zevaryx/ender-5-mint-edition/docs/index.md

---
icon: lucide/rocket
---

# Getting started

## About this project

This project is a way to maximize the capabilities of the Ender 5 Max. Creality leaves a lot of performance on the table, as well as made questionable decisions with the electronics.

!!! danger "Advanced Project"

    This project is not for the faint of heart. You will be replacing all of the core electronics and the toolhead with custom parts. This projects comes with no warranty, and I do not claim any responsibility for damage to the printer, you, or to your housing. Fires are a serious risk when doing this project, and the danger of electrocution is present when dealing with mains voltage.

    **You have been warned**

## Results

<video width="1080" height="1920" controls>
  <source src="media/videos/0-benchy-smaller.mp4" type="video/mp4">
</video>

<video width="1080" height="1920" controls>
  <source src="media/videos/1-benchy-smaller.mp4" type="video/mp4">
</video>

## CAD Files

### Enclosure

<iframe src="https://unco1.autodesk360.com/shares/public/SH28cd1QT2badd0ea72b91c8bcb635015e0a?mode=embed" width="800" height="600" allowfullscreen="true" webkitallowfullscreen="true" mozallowfullscreen="true"  frameborder="0"></iframe>

### EVA3 UHF Duct for Cartographer V4

Uses a Rapido 2 UHF hotend as the example

<iframe src="https://unco1.autodesk360.com/shares/public/SH28cd1QT2badd0ea72b017430b5294d3c46?mode=embed" width="800" height="600" allowfullscreen="true" webkitallowfullscreen="true" mozallowfullscreen="true"  frameborder="0"></iframe>

| Part | Fusion | STEP |
| --- | --- | --- |
| Enclosure | [.f3z](cad/enclosure/Ender%205%20Max%20Manta%20M8P%2048V%20Enclosure.f3z) | [.step](cad/enclosure/Ender%205%20Max%20Manta%20M8P%2048V%20Enclosure.step) |
| EVA3 UHF Duct | [.f3z](cad/eva3/EVA3%20UHF%20Duct%20Cartographer%20V4.f3d) | [.step](cad/eva3/EVA3%20UHF%20Duct%20Cartographer%20V4.step) |

## Recommended tools

!!! info

    This list is not exhaustive, and just what I could come up with off the top of my head

- A good soldering iron (Pinecil V2, TS100/101, FNISRI HS-02A/B, anything Weller/Hakko, etc)
- CNCKitchen heat-set insert tool for your soldering iron
- A good set of allen wrenches
- A good pair of wire strippers
- Ferrule crimps and a crimper for them
- Fork crimps and a crimper for them
- A good JST crimper and various sizes of JST plugs and crimps
- High-quality wire of various gauges, including large gauge for mains voltage (I used trailer wiring from Home Depot)
- Zip ties. Lots and lots of zip ties
- Flush cutters
