zevaryx/ender-5-mint-edition/docs/stl/enclosure/LRS-350-24.stl

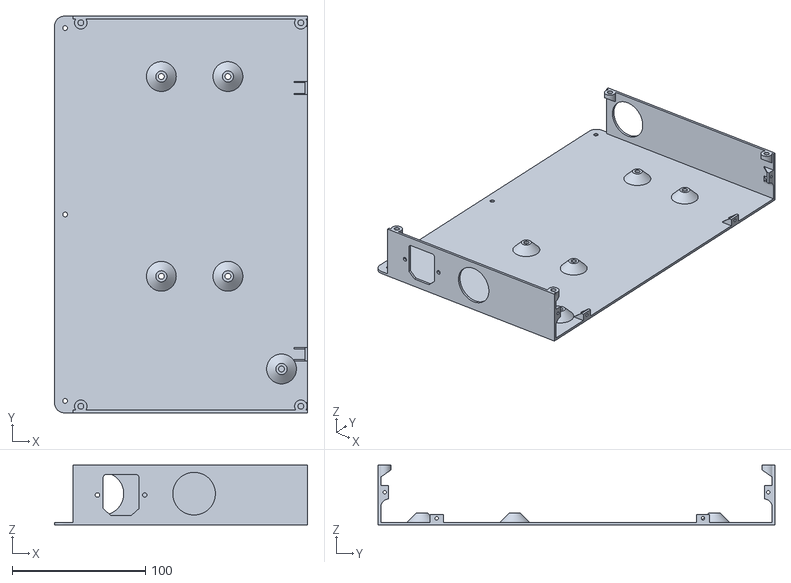
[picture p4: CAD file, 2025-12-09]
docs/stl/enclosure/LRS-350-24.stl
190.0 x 298.0 x 45.0
