zevaryx/ender-5-mint-edition/docs/stl/eva3/EVA3 UHF Duct Cartographer V4.3mf

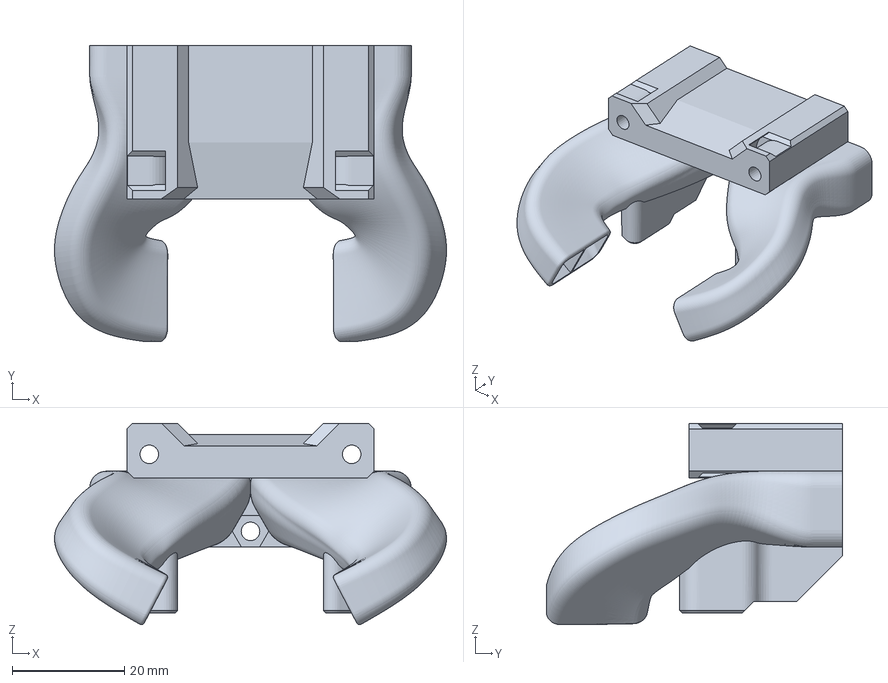
[picture p5: CAD file, 2025-12-19]
docs/stl/eva3/EVA3 UHF Duct Cartographer V4.3mf
69.7 x 52.7 x 35.8 mm
