zevaryx/ender-5-mint-edition/docs/stl/enclosure/Foot Extension x4.stl

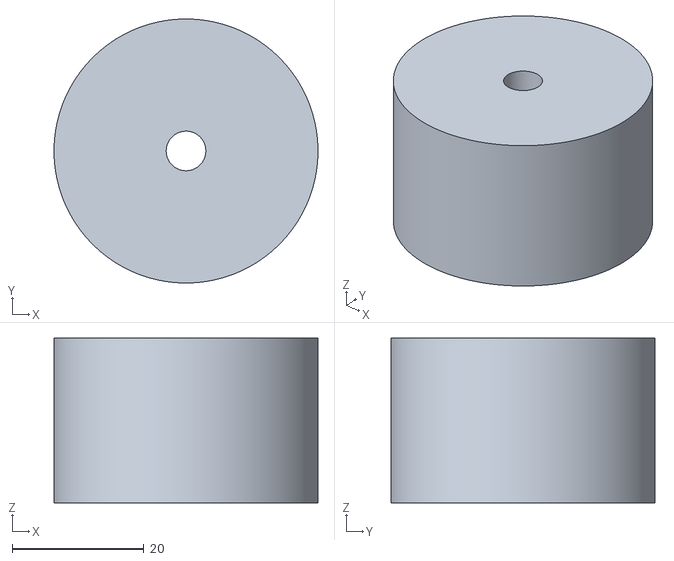
[picture p6: CAD file, 2025-12-09]
docs/stl/enclosure/Foot Extension x4.stl
40.0 x 40.0 x 25.0
