zevaryx/ender-5-mint-edition/docs/stl/eva3/E5M EVA Back Insert.stl

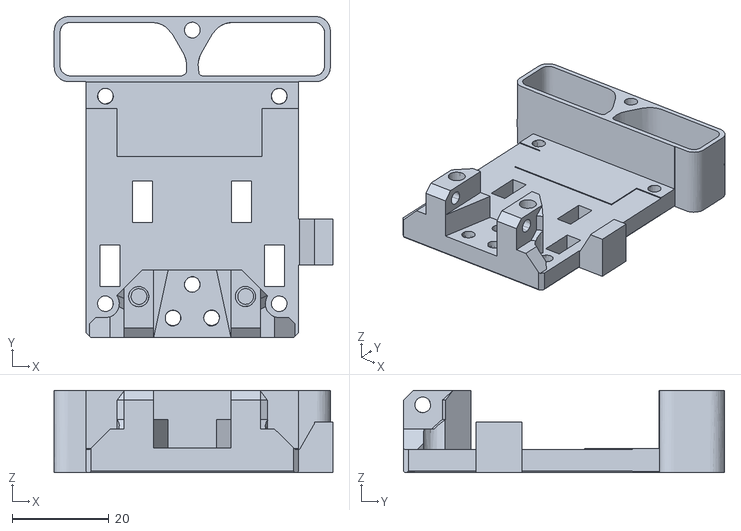
[picture p7: CAD file, 2025-12-09]
docs/stl/eva3/E5M EVA Back Insert.stl
57.7 x 66.5 x 17.0
