zevaryx/ender-5-mint-edition/docs/stl/enclosure/Manta M8P.stl

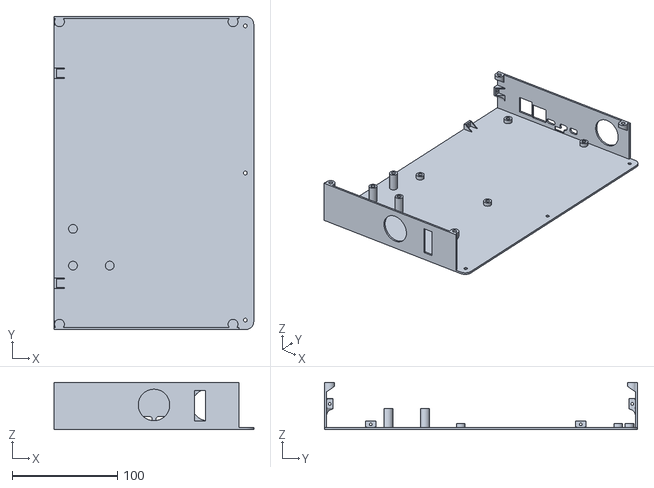
[picture p8: CAD file, 2025-12-09]
docs/stl/enclosure/Manta M8P.stl
190.0 x 298.0 x 45.0
