zevaryx/ender-5-mint-edition/docs/stl/eva3/E5M EVA Top Insert.stl

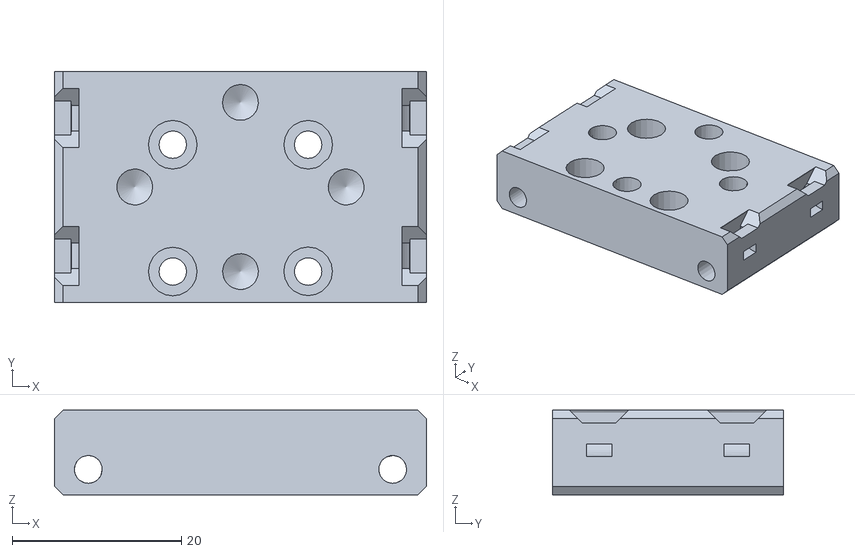
[picture p9: CAD file, 2025-12-09]
docs/stl/eva3/E5M EVA Top Insert.stl
44.0 x 27.3 x 10.0
