zevaryx/ender-5-mint-edition/docs/stl/enclosure/Bottom Mesh - LRS-200-48.stl

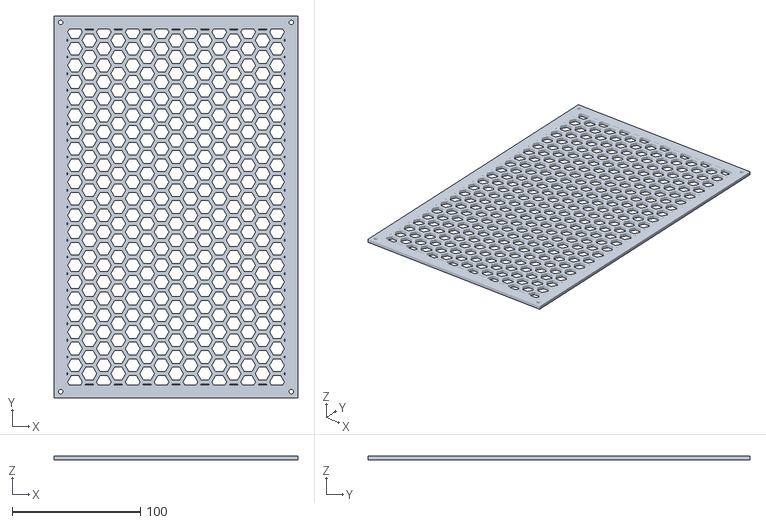
[picture p10: CAD file, 2025-12-09]
docs/stl/enclosure/Bottom Mesh - LRS-200-48.stl
190.0 x 298.0 x 3.00
