zevaryx/ender-5-mint-edition/docs/stl/eva3/E5M EBB36 Orbiter Mount.stl

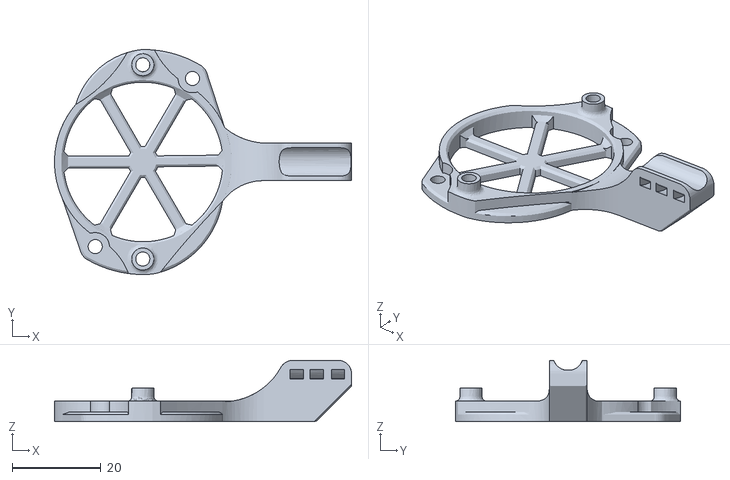
[picture p11: CAD file, 2025-12-09]
docs/stl/eva3/E5M EBB36 Orbiter Mount.stl
67.0 x 50.8 x 13.9
