zevaryx/ender-5-mint-edition/docs/stl/enclosure/Bottom Mesh - Manta M8P.stl

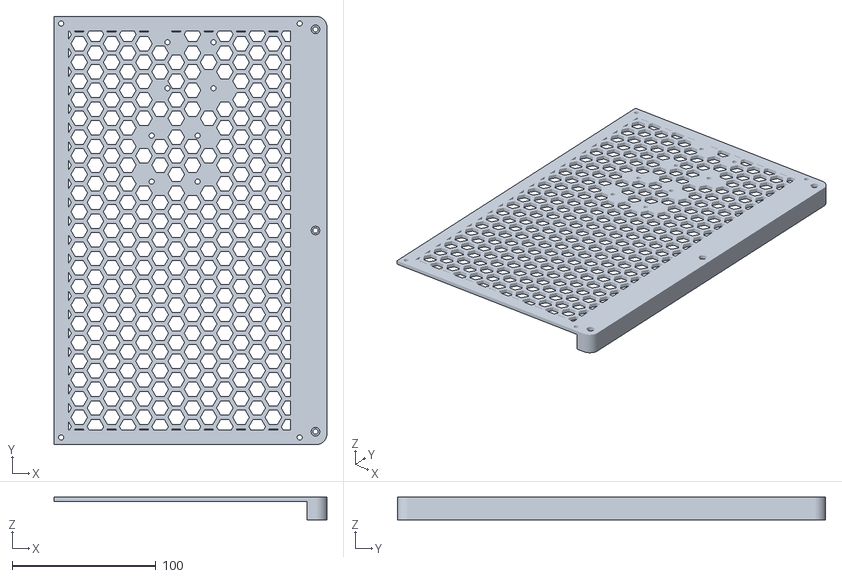
[picture p12: CAD file, 2025-12-09]
docs/stl/enclosure/Bottom Mesh - Manta M8P.stl
190.0 x 298.0 x 16.0
