zevaryx/ender-5-mint-edition/docs/stl/eva3/E5M SFS Mount.stl

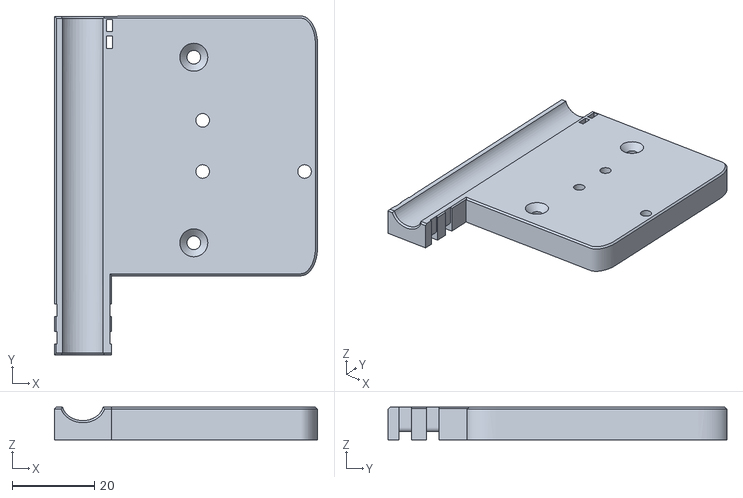
[picture p13: CAD file, 2025-12-09]
docs/stl/eva3/E5M SFS Mount.stl
63.8 x 82.2 x 7.99
