zevaryx/ender-5-mint-edition/docs/stl/eva3/E5M EVA Front Insert.stl

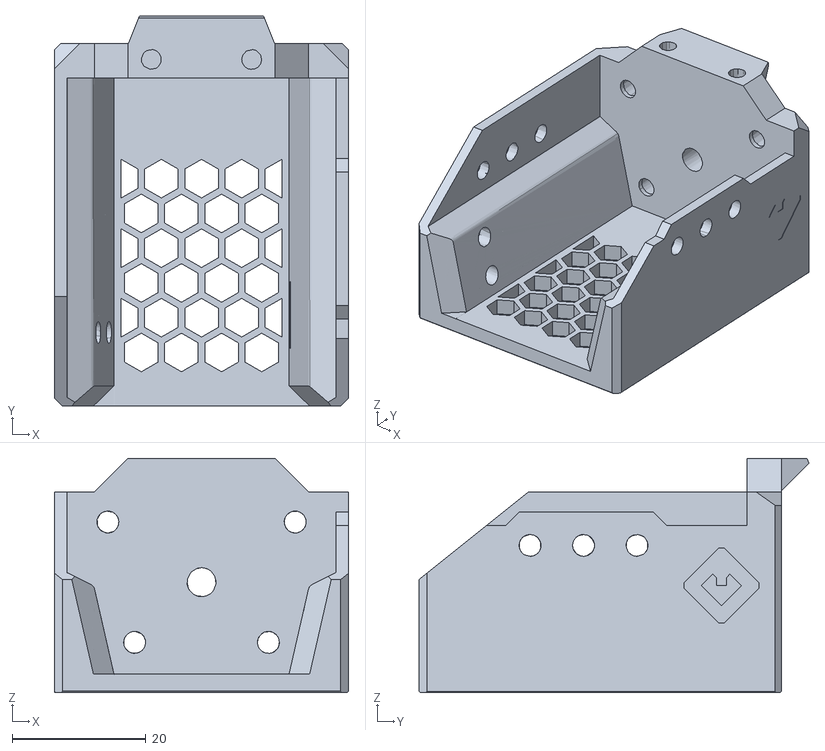
[picture p14: CAD file, 2025-12-09]
docs/stl/eva3/E5M EVA Front Insert.stl
44.0 x 58.3 x 35.0
