zevaryx/ender-5-mint-edition/(list of files, cad)

Other CAD files:
docs/stl/enclosure/LRS-200-48.stl
docs/stl/enclosure/Bottom Mesh - LRS-350-24.stl
docs/cad/eva3/EVA3 UHF Duct Cartographer V4.f3d
