zevaryx/ender-5-mint-edition/(commit log)

2025-12-09 Starts of the BOM
2025-12-09 Add mostly finished BOM, Getting Started
    [Bottom Mesh - LRS-200-48.stl, Bottom Mesh - LRS-350-24.stl, Bottom Mesh - Manta M8P.stl, E5M EBB36 Orbiter Mount.stl, E5M EVA Back Insert.stl, E5M EVA Front Insert.stl, E5M EVA Top Insert.stl, E5M SFS Mount.stl]
2025-12-09 Add CAD files and embedded Fusion viewer
2025-12-10 Add basics of assembly guide
2025-12-10 Add more to assembly guide
2025-12-10 Add fan mounting info
2025-12-19 Add CAD files for the EVA3 UHF for Carto V4
    [EVA3 UHF Duct Cartographer V4.3mf, EVA3 UHF Duct Cartographer V4.f3d]
2026-01-24 Fix links in BOM
